MarkHedleyJones/paper_autonomousPlatform/images/software_v2.pdf

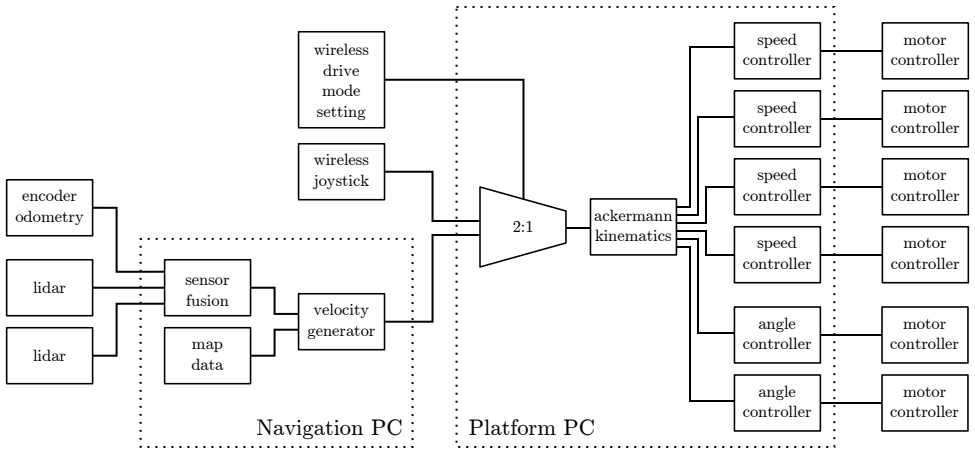
[picture p3: figure]
lidar; sensor fusion; encoder odometry; velocity generator map; data; motor; controller; motor controller; Navigation PC; Platform PC; speed controller; ackermann kinematics; wireless drive mode setting; wireless; joystick; speed; angle controller
