MarkHedleyJones/paper_autonomousPlatform/images/diagram_v5.pdf

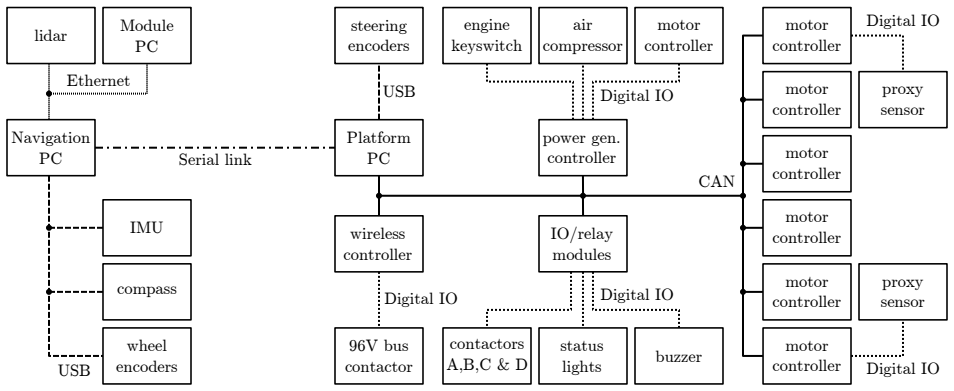
[picture p4: figure]
motor controller; wireless controller; power gen. controller; IO/relay modules; air compressor; engine keyswitch; Digital IO; 96V bus; contactor; buzzer status; lights; contactors A,B,C & D; Platform PC; steering encoders; USB; CAN; Navigation PC; Module PC; Serial link; lidar; proxy sensor; Ethernet; IMU; wheel encoders; compass
