MarkHedleyJones/paper_autonomousPlatform/images/row_tracking_repeatability.pdf

1

2

3

4

5
Trial number

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
Deviation from average (m)
