MarkHedleyJones/paper_autonomousPlatform/images/paths_end_points.pdf

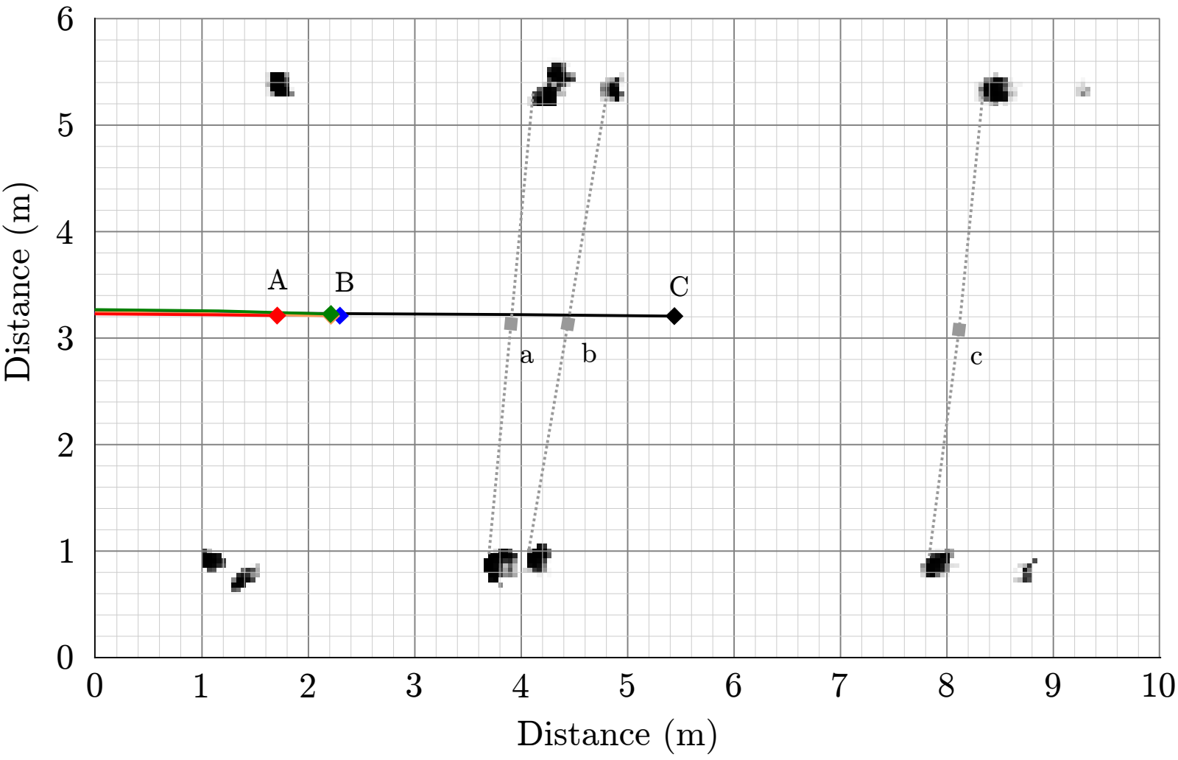
[picture p5: page 1]

0 | 1 | 2 | 3 | 4 | 5 | 6 | 7 | 8 | 9 | 10

1

2

3

4

5

6

0

Distance (m)

A

a

B

b

C

c

Distance (m)
