MarkHedleyJones/paper_autonomousPlatform/images/paths2.pdf

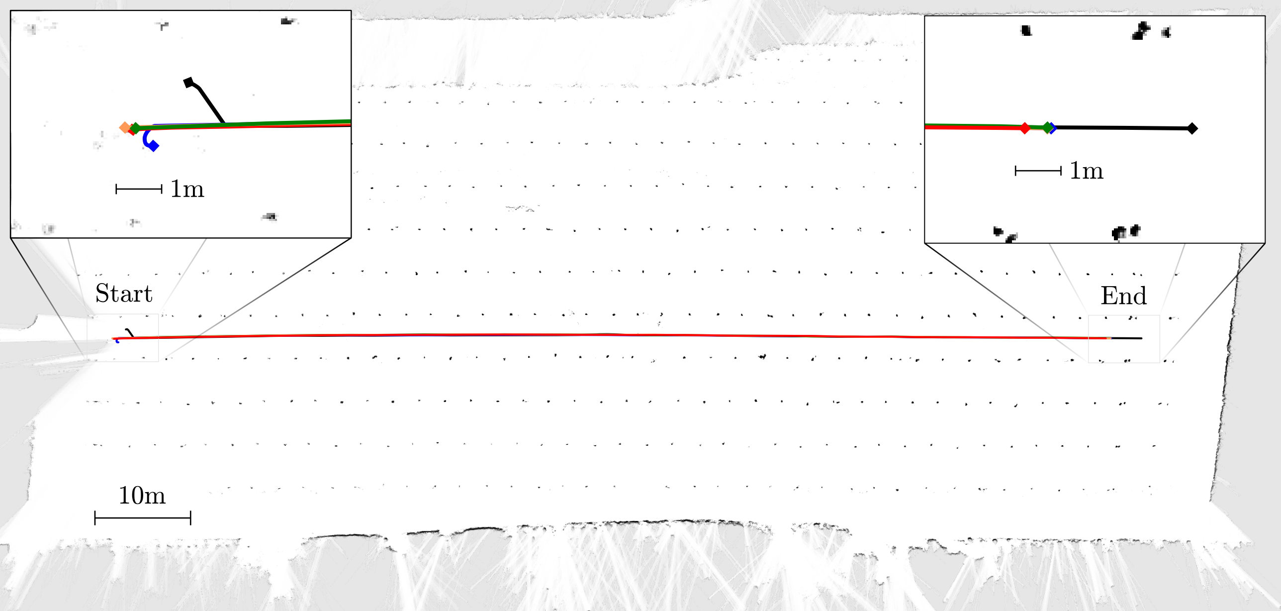
[picture p6: page 1]

10m

Start | End

1m

| 1m
