MarkHedleyJones/paper_autonomousPlatform/images/flowchart.pdf

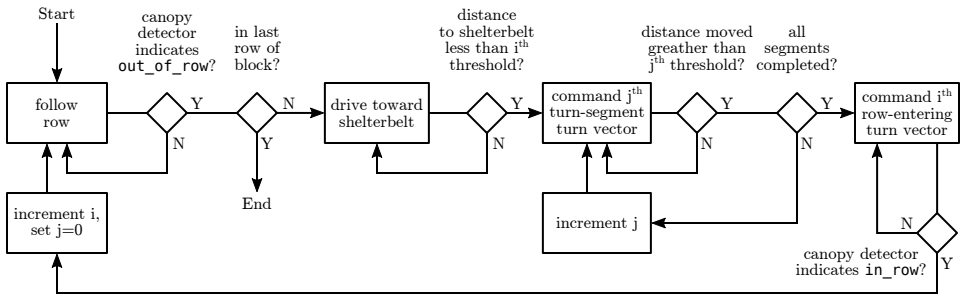
[picture p7: figure]
Start; End; follow row; canopy detector indicates out_of_row?; in last row of block?; drive toward shelterbelt; increment j; all segments completed?; command ith row-entering turn vector; canopy detector indicates in_row?; command jth turn-segment turn vector; distance moved greather than j; th threshold?; distance to shelterbelt less than ith threshold?; increment i, set j=0
