MarkHedleyJones/paper_autonomousPlatform/images/camera_comparison.pdf

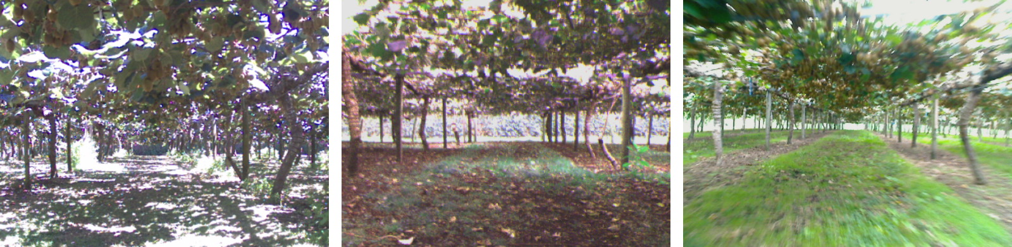
[picture p8: page 1]
