MarkHedleyJones/paper_autonomousPlatform/imgs/profile_views/AMMP - Side.DXF

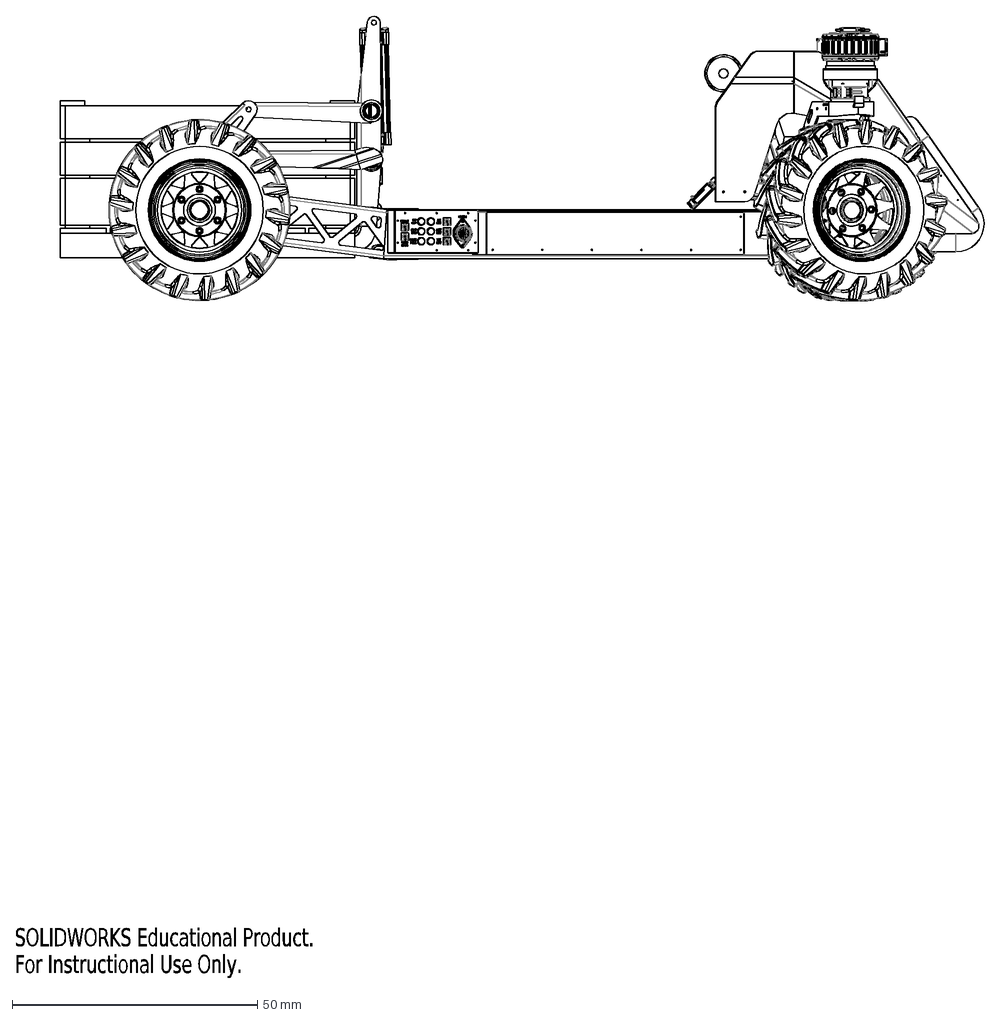
[picture p9: CAD file, 2017-07-25, last stored version]
imgs/profile_views/AMMP - Side.DXF
SOLIDWORKS Educational Product.
For Instructional Use Only.
