MarkHedleyJones/paper_autonomousPlatform/(threads)

Thread 10 (2019-05-07):

Incorrect reference

MarkHedleyJones, 2019-05-07:
Line 755: Correct the reference.

Checkout `revision_2` tag to see the state of the paper as submitted for the previous revision (to align line-numbers)

mjseabright, 2019-05-13:
Fixed

mjseabright, 2019-05-22:
Is there a reason you reopened this? I believe it's fixed in my edits.

MarkHedleyJones, 2019-05-22:
I reopened it so that when the relevant pull-request was merged it would automatically close this issue and add a message to this issue stating that it was closed by such and such a pull request. That way I/we can look back and find where/how this issue was closed (with a trace to the commit that closed it). However, I think because you merged the branch without me having approved it, GitHub doesn't consider the changes valid and therefore didn't close the associated issues. Or maybe it's because I added the closes #X references and not you. Hmm, I'm not sure. You're free to reclose this issue after you've read this. Essentially, you should never have to write Fixed as a comment in an issue because if you use the keywords correctly, GitHub will take care of linking the issues and pull-requests and close them when they're dealt with. Also, until your pull-requests have been approved by whoever you've asked for a review from, you shouldn't merge it (but it's fine for here) :smile:

mjseabright, 2019-05-22:
Sorry about merging the pull request. I thought that I should merge it after checking the changes you requested. But rereading it, I can see that isn't the case. I'm glad I'm learning this stuff here and not on a 'more important' project where people might not be so understanding.

As for this issue, it is now fixed so I'll close it.

Closed 2019-05-22.

Thread 5 (2019-05-07):

Fix typo

MarkHedleyJones, 2019-05-07:
Line 197: correct to “a torque of 388 Nm”.

Be aware that the line numbers are likely to have changed as a result of edits. You can checkout the `revision_2` tag to see the state of the paper at submission.

mjseabright, 2019-05-13:
Fixed

mjseabright, 2019-05-22:
I think this should be closed, as it's fixed by #15. Am I missing something?

MarkHedleyJones, 2019-05-22:
No no, sorry. See my comment in #10. You're free to re-close.

Closed 2019-05-22.

Thread 6 (2019-05-07):

Change title of Sections 4.0.1 to 4.0.3

MarkHedleyJones, 2019-05-07:
Sections 4.0.1 to 4.0.3 report qualitative evaluations of sensors, as there was no experimental design and no data analyses. So, change each title to “… qualitative evaluation”.

Closed 2019-05-28.

Thread 13 (2019-05-09):

Reviewer 2 comments

MarkHedleyJones, 2019-05-09:
A decision about its suitability for publication depends on whether main results reported in the paper are original or whether its important points are logically emphasized. Following are the issues to be addressed in my mind.

Main contents of the paper are the documentation about the design of a motor-driven platform and its field testing. As compared to the previous version of the paper, lot of technical improvements have been made including the addition of information about platform design and details of the field testing data. However, overall, this paper somewhat focused on a low-level control related to the operation of the motor platform. Relatively, technical  information about high-level control, i.e. autonomous path detection and tracking, was not so sufficiently provided. In a way, it seems to me that it is still uncertain in deciding whether the platform was automatically traveled with a level of satisfaction because of no clear mention of the ability to travel between the trees and turn at each of end points. Basically, I could not clearly understand what algorithms were implemented for autonomous path tracking based on the use of optical sensors because no data were shown to support that the tracking algorithm developed in the study was superior to conventional methods when operated under canopy in an orchard. Even though, research on the algorithms was conducted in previous studies, I would like the authors to simply describe the algorithms so that readers could easily understand the results of this study. Figures 7, 8, and 10 did not clearly show how well the autonomous platform worked in orchards. Instead, the figures might be part of the results obtained with preliminary tests. It was necessary to include either numerical data or figures that show how the objects were successfully detected and how the reference lines for the platform to travel were identified using appropriate image processing methods and path tracking algorithms, respectively, because I thought one of the most important techniques in this study was how the platform automatically traveled between trees and turned at end points based on real-time data obtained with cameras. I could not clearly understand what exactly some of the figures added in the revised version of the paper meant, i.e., Figures 13 to 16. For example,
it seems to me that the meaning of Fig. 13, the acceleration profile of the platform, was unclear to me in estimating the platform weight. In addition, I don't think it is a good idea to use bar charts displayed in Figs. 14 and 15 and path tracks in Fig. 16 when evaluating the platform performance in a quantitatively manner because readers have a difficulty in determining how well the platform work. As a method, I would like the authors to consider of the use of standard deviations from the target lines. I would like the authors to rework on the abstract because it contains no numerical data and important information is missing, such as what camera and image processing method were selected in orchard under canopy. In addition, it should be mentioned how the platform with an Ackerman motor system was automatically steered at corners if possible. Finally, it might be better to change the current title of the manuscript into "the design of ~platform and its testing "in order to deliver the key contents of the manuscript more clearly.
