MarkHedleyJones/paper_autonomousPlatform/images/AMMP-All-Labelled.pdf

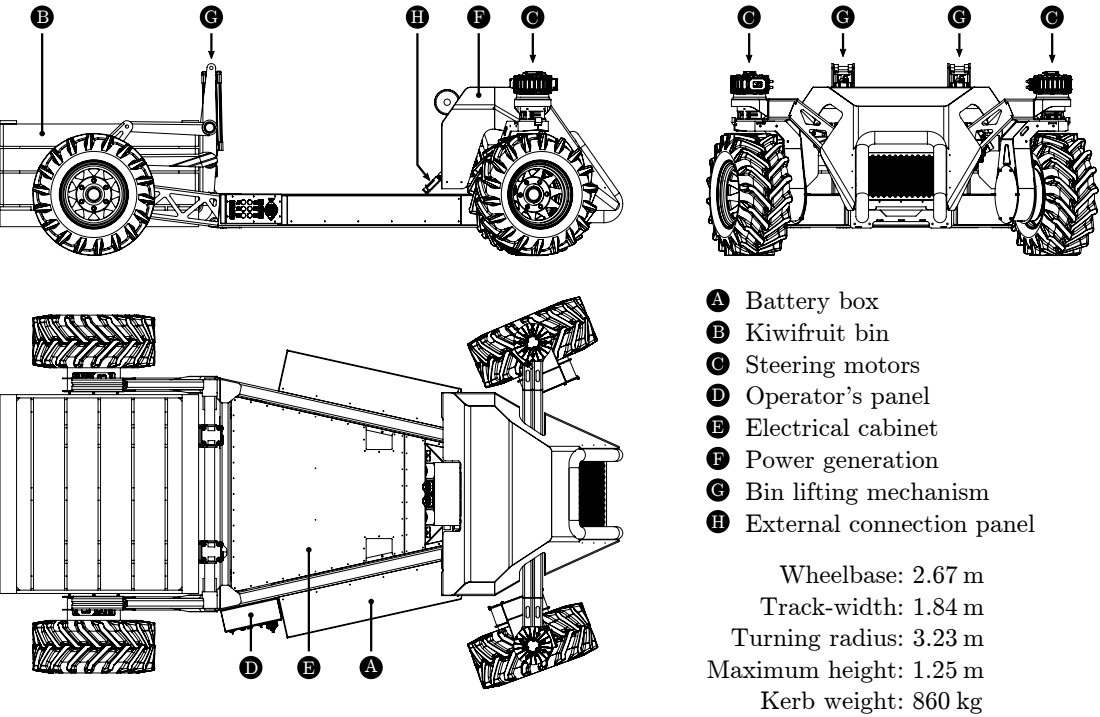
[picture p10: page 1]
Battery box Kiwifruit bin Steering motors Operator's panel Electrical cabinet Power generation Bin lifting mechanism External connection panel

Wheelbase: 2.67
Track-width: 1.84
Turning radius: 3.23
Maximum height: 1.25
Kerb weight: 860 kg
