MarkHedleyJones/paper_autonomousPlatform/images/full-system-diagram_v1.pdf

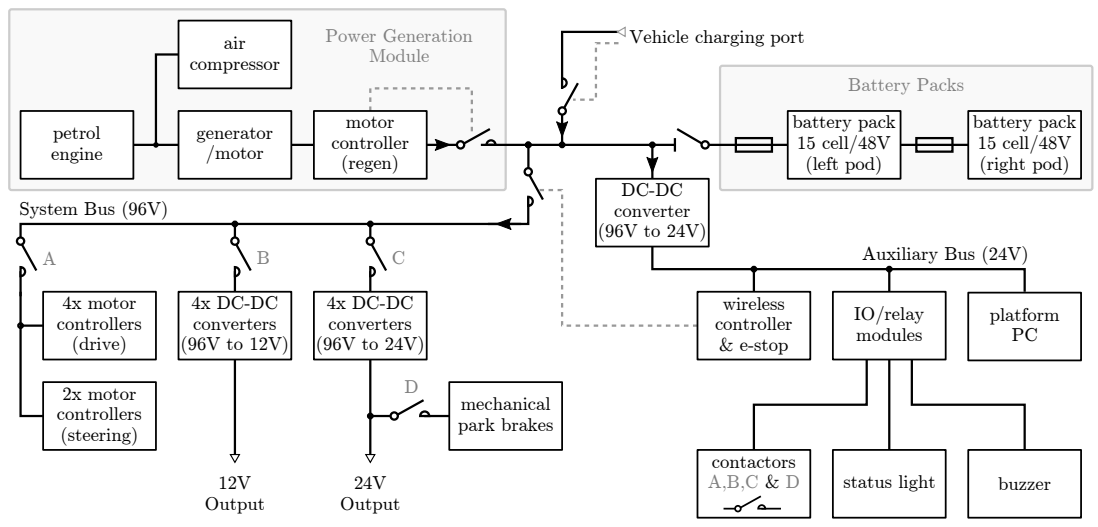
[picture p11: page 1]
air compressor; petrol engine; generator /motor; motor controller (regen); System Bus (96V); battery pack 15 cell/48V (left pod); battery pack 15 cell/48V (right pod); 4x motor controllers (drive); 2x motor controllers (steering); 4x DC-DC converters (96V to 12V); 4x DC-DC converters (96V to 24V); mechanical park brakes; 12V Output; 24V Output; wireless controller & e-stop; DC-DC converter (96V to 24V); IO/relay modules; Auxiliary Bus (24V); platform PC; status light; buzzer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

Vehicle charging port
