MarkHedleyJones/paper_autonomousPlatform/images/segmented_analysis_with_centres.pdf

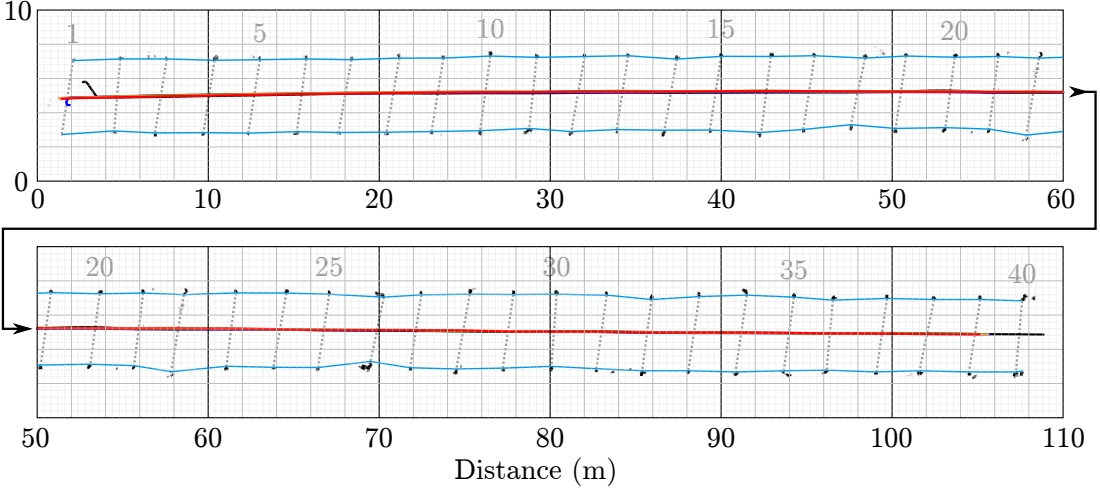
[picture p12: page 1]
Distance (m)
