MarkHedleyJones/paper_autonomousPlatform/images/row_tracking_averages.pdf

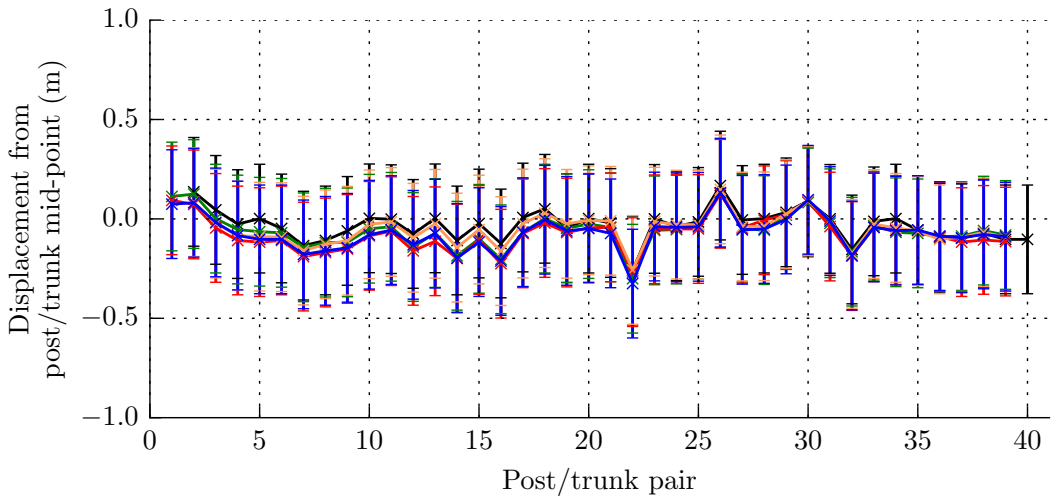
[picture p13: page 1]
Displacement from

post/trunk mid-point (m)

Post/trunk pair
