MarkHedleyJones/paper_autonomousPlatform/images/graph_acceleration.pdf

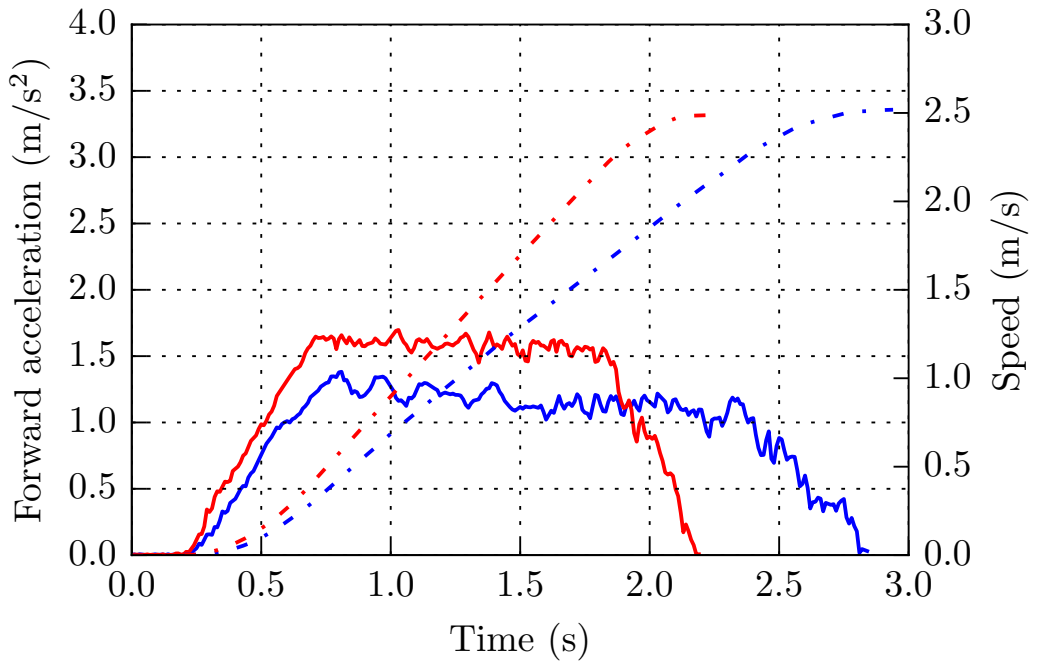
[picture p14: page 1]
Time (s); Forward acceleration (m/s2); Speed (m/s)
