MarkHedleyJones/paper_autonomousPlatform/images/concave_slope_v4.pdf

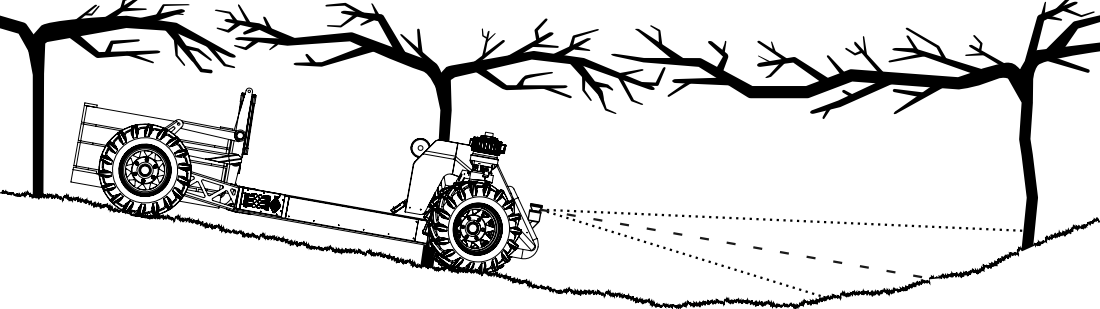
[picture p15: page 1]
