MarkHedleyJones/paper_autonomousPlatform/images/canopy_data.pdf

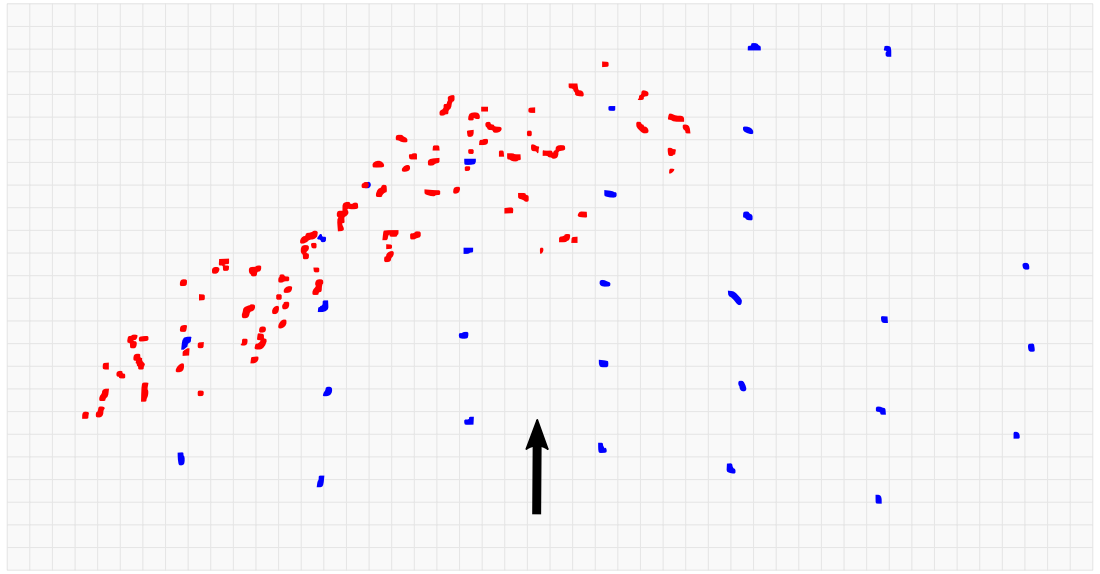
[picture p16: page 1]
