MarkHedleyJones/paper_autonomousPlatform/(commit log)

2017-07-25 Updated AMMP diagram
    [AMMP - Side.DXF]
2017-07-31 bulk of sensor selection section added
2017-07-31 bulk of sensor selection photos
2017-08-01 Added references, and started working the sensor selection review into the main review
2017-08-01 adding references file and final image for sensor selection section
2017-08-01 Expanding out sensor review
2017-08-01 references and inference results added for sensor selection
2017-08-03 Edited sensor selection review
2017-08-14 Started rewording navigation sensors
2017-08-16 Reworded lidar section
2017-08-16 Removed old lidar text
2017-08-16 Merged camera based selection sections and reworded
2017-08-16 Edited Sensor demonstration section
2017-08-17 Worked the lidar algorithm section
2018-06-10 Added power system diagram and editied a lot
2018-06-12 Added detail about power-gen
2018-06-14 Added chassis diagram and more editing
2018-11-23 Renamed attached file
2018-12-06 Added row tracking graph
    [tracking.csv]
2018-12-08 Updated row following section
    [row_follow_analysis.ods]
2018-12-09 Added information about drive system performance
    [climb.csv, data.ods, flat.csv]
2019-05-22 Added missing bracket
2019-05-22 Changed velocity to speed to avoid confusion.
2019-05-29 Improved y-axis label
2019-06-17 Updated curb weight to 860kg in profile views
2019-09-05 Removed commented material
2019-09-05 Flattened img folder, separated src files, and removed unused images
    [AMMP - Side.DXF, climb.csv, data.ods, flat.csv, row_follow_analysis.ods, tracking.csv]
2019-09-05 Renamed image folders
    [climb.csv, flat.csv, tracking.csv]
2019-09-05 Added current pdf to compiled pdfs folder
